jreus/imac-pcb/imac-pcb-front.png

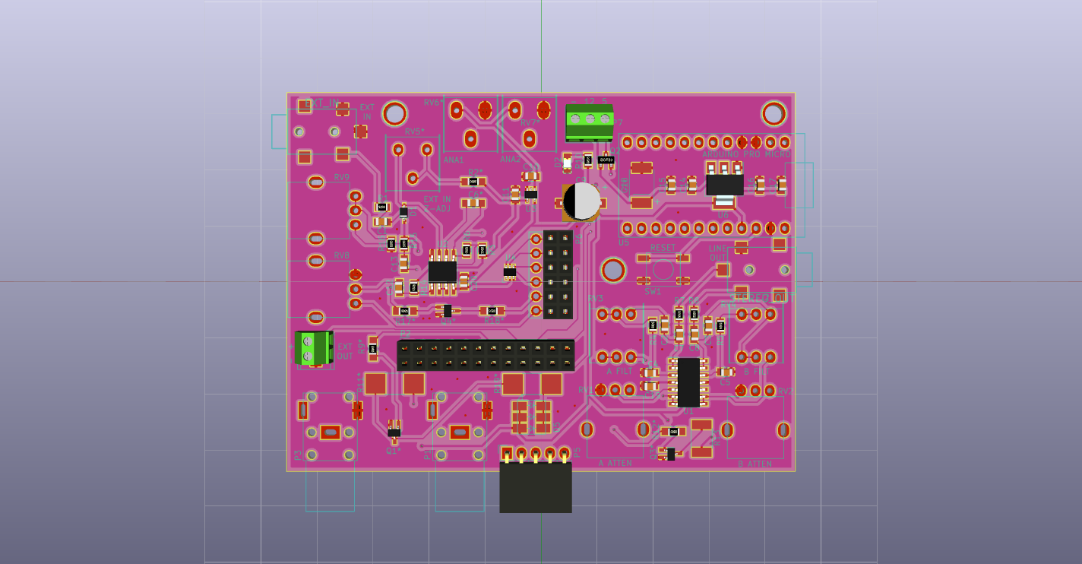
imac-pcb-front.png
