jreus/imac-pcb/imac-pcb-back.png

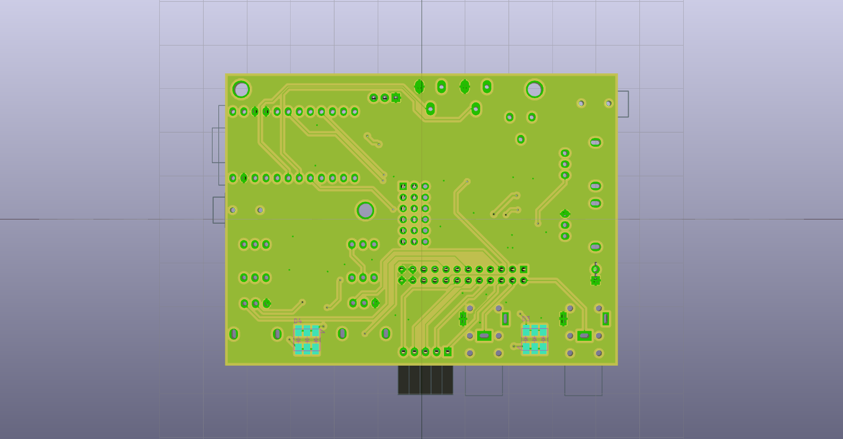
imac-pcb-back.png
