jreus/imac-pcb/Documentation/imac-pcb-3d-v01.png

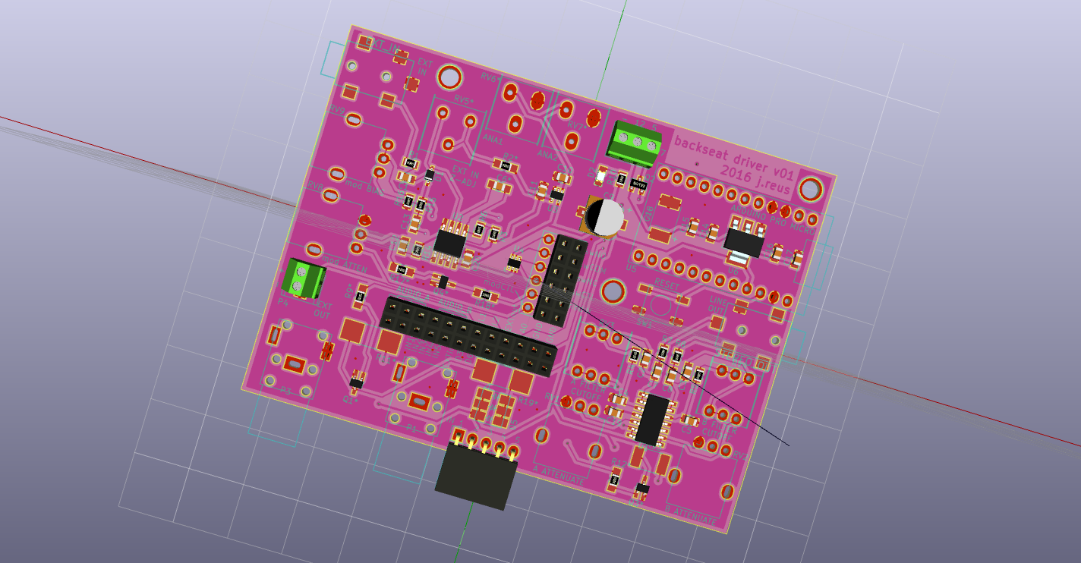
Documentation/imac-pcb-3d-v01.png
