jreus/imac-pcb/Documentation/Simulation/CREE-3SMD-transistor-drivers.png

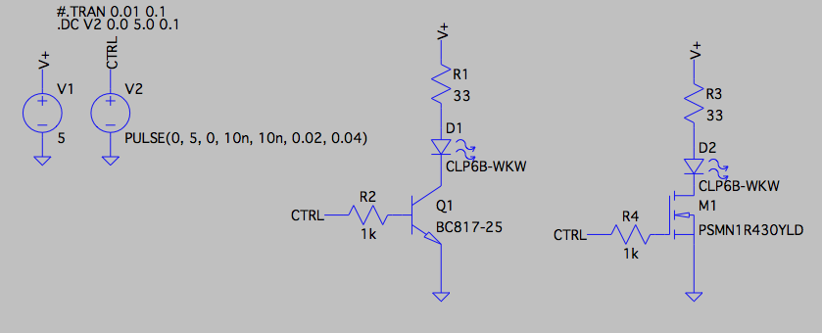
Documentation/Simulation/CREE-3SMD-transistor-drivers.png
