jreus/imac-pcb/Documentation/Simulation/mod_input_stage02.png

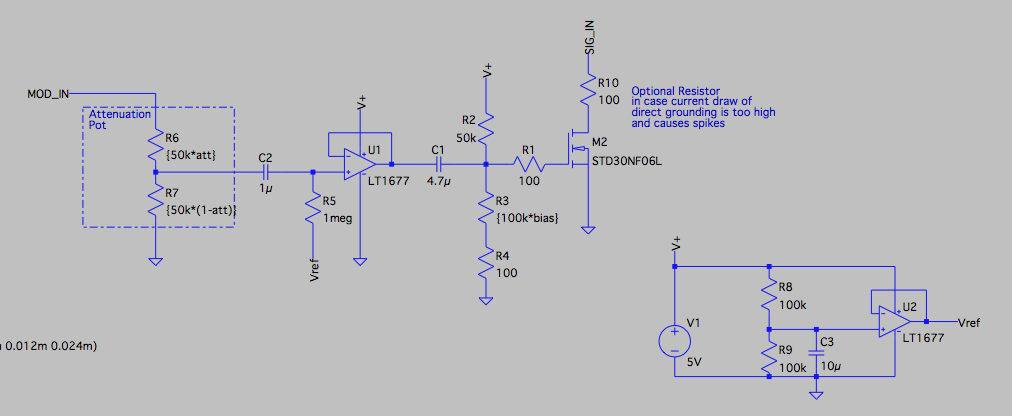
Documentation/Simulation/mod_input_stage02.png
