jreus/imac-pcb/Documentation/Simulation/mod_input_stage.png

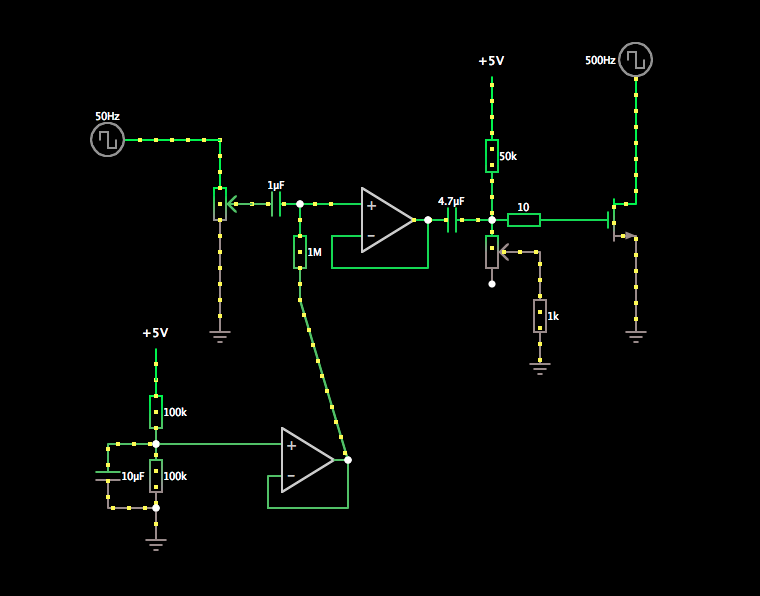
Documentation/Simulation/mod_input_stage.png
