jreus/imac-pcb/imac-pcb-BOM.ods

Sheet: BOM_RUN1
Notes | Link | Value | # per board | Footprint | Supplier | Supplier no | Cost/unit | Cost/N | N | MIN N | Cost/Board | In hand | Tot Needed (6 boards) | Still To order
PCB COMPONENTS
CONNECTORS
 | http://nl.farnell.com/lumberg/1503-03/connector-receptacle-3-5mm-phono/dp/1216980 | 3.5mm SMD headphone connector | 2 |  | Farnell | 1216980 | € 2.5200 | € 2.52 | 1 |  | € 5.0400 | 6 | 12 | 6
bigger wire gauge & lower price | http://nl.farnell.com/te-connectivity-buchanan/282834-3/terminal-block-wire-to-brd-3pos/dp/2396254 | 3x terminal block 16awg 282834-3 | 1 | 2.54mm x3 | Farnell | 2396254 | € 1.1500 | € 1.15 | 1 |  | € 1.1500 | 1 | 6 | 5
optional for breakout points | http://nl.farnell.com/te-connectivity-buchanan/282834-2/terminal-block-wire-to-brd-2pos/dp/2112482 | 2x terminal block 16awg 282834-2 | 1 | 2.54mm x2 | Farnell | 2112482 | € 1.0100 | € 1.01 | 1 |  | € 1.0100 | 1 | 6 | 5
 | http://nl.farnell.com/pro-signal/psg01546/socket-phono-pcb-gold-white/dp/1280701 | 2 pack RCA socket white | 1 |  | Farnell | 1280701 | € 1.1600 | 1.16 | 1 |  | € 1.1600 | 2 | 6 | 4
 | http://nl.farnell.com/samtec/ces-105-02-t-s-ra/socket-2-54mm-r-a-1x5way/dp/1803400 | 5x1 header fem angled | 1 | 2.54mm x5 | Farnell | 1803400 | € 0.5740 | € 14.35 | 25 | 25 | € 0.5740 | 10 | 6 | -4
 | http://nl.farnell.com/samtec/ssw-112-01-t-d/socket-2-54mm-2x12way/dp/1804590 | 12x2 fem header | 1 | 2.54mm x2x12 | Farnell | 1804590 | € 2.5000 | € 2.50 | 1 |  | € 2.5000 | 10 | 6 | -4
 | http://nl.farnell.com/samtec/ssw-106-01-t-t/socket-2-54mm-3x6way/dp/1804317 | 6x3 fem header | 1 | 2.54mm x3x6 | Farnell | 1804317 | € 1.5900 | € 15.90 | 10 | 10 | € 1.5900 | 10 | 6 | -4
 | http://nl.farnell.com/multicomp/2212s-12sg-85/socket-pcb-1-row-12way/dp/1593465 | 12x1 fem header | 2 | 2.54mm x2x12 | Farnell | 1593465 | € 0.1760 | € 3.52 | 20 | 5 | € 0.3520 | 0 | 12 | 12
POTS & TRIMMERS & SWITCHES |  |  |  |  |  |  | #DIV/0! |  |  |  | #DIV/0! | 0 | 0 | 0
 | http://nl.farnell.com/bourns/3386f-1-104tlf/trimmer-100k/dp/9354581 | 100k thru-hole trimpot with knob | 1 | 2.54mm x3 tri | Farnell | 9354581 | € 3.3800 | € 3.38 | 1 |  | € 3.3800 | 3 | 6 | 3
 | http://nl.farnell.com/vishay/m63m105kb30t607/trimmer-1m/dp/9608290 | 1meg thru-hole trimpot with knob | 1 | 2.54mm x3 tri | Farnell | 9608290 | € 1.9000 | € 19.00 | 10 | 10 | € 1.9000 | 3 | 6 | 3
 | http://nl.farnell.com/bourns/3310h-001-104l/potentiometer-100k/dp/9353933 | stereo 100k linpot bourns | 2 | 2.54mm x3 x2 rows | Farnell | 9353933 | € 7.4000 | € 7.4000 | 1 |  | € 14.8000 | 2 | 12 | 10
 | http://nl.farnell.com/bourns/ptv09a-4020f-b104/pot-rotary-100kohm-9mm-20/dp/2469525 | 100k 20% linpot bourns 9mm | 4 | 2.54mm x3 row | Farnell | 2469525 | € 0.9570 | 0.957 | 1 |  | € 3.8280 | 6 | 24 | 18
 |  | knob |  |  |  |  | #DIV/0! |  |  |  | #DIV/0! | 0 | 0 | 0
 |  | knob |  |  |  |  | #DIV/0! |  |  |  | #DIV/0! | 0 | 0 | 0
reset button | http://nl.farnell.com/c-k-components/ksem31g-lfs/tactile-switch-spst-0-05a-32vdc/dp/2435310 | SMD tactile switch | 1 |  | Farnell | 2435310 | € 0.2580 | 0.258 | 1 |  | € 0.2580 | 0 | 6 | 6
 |  |  |  |  |  |  |  |  |  |  |  |  | 0
DISCREET SEMICONDUCTORS |  |  |  |  |  |  |  |  |  |  |  |  | 0
For LED driver circuits or as an alternative MOSFET? | http://nl.farnell.com/nxp/nx3008nbkw/mosfet-n-ch-30v-350ma-sot323/dp/2069546 | NX3008N MOSFET | 3 | SOT323 / SC-70 | Farnell | 2069546 | € 0.0527 | € 1.32 | 25 | 25 | € 0.1581 | 0 | 18 | 18
Why did I buy this? For LED driver circuits? | http://nl.farnell.com/nxp/bc817-25-215/transistor-bjt-npn-45v-0-5a-sot/dp/1081224 | BC817 BJT NPN transistor | 3 | SOT323 / SC-70 | Farnell | 1081224 | € 0.0101 | € 0.01 | 1 |  | € 0.0303 | 0 | 18 | 18
polarity protection p-chan mosfet. Vgs 12v max | http://nl.farnell.com/nxp/pmv48xp/mosfet-p-ch-20v-3-5a-sot23/dp/1894743 | PMV48XP P-ch mosfet | 1 | SOT23 | Farnell | 1894743 | € 0.1930 | € 0.19 | 1 | 1 | € 0.1930 | 0 | 6 | 6
surge protect small sig diodes | http://nl.farnell.com/fairchild-semiconductor/1n4148ws/diode-small-signal-75v-sod-323f/dp/2453269 | 1N4148 | 1 | SOD-323F | Farnell | 2453269 | € 0.1390 | € 0.70 | 5 | 5 | € 0.1390 | 0 | 6 | 6
 |  |  |  |  |  |  |  |  |  |  |  |  | 0
ICs |  |  |  |  |  |  |  |  |  |  |  |  | 0
quad op-amp | http://nl.farnell.com/microchip/mcp6004-e-sl/ic-op-amp-quad-1mhz-smd-soic14/dp/1332122 | MCP6004 | 1 | SOIC14 | Farnell | 1332122 | € 0.4390 | € 4.39 | 10 | 10 | € 0.4390 | 4 | 6 | 2
dual op-amp | http://nl.farnell.com/microchip/mcp6002-e-sn/ic-op-amp-1mhz-0-6v-us-4500uv/dp/1332118 | MCP6002 | 1 | SOIC8 | Farnell | 1332118 | € 0.3360 | € 3.36 | 10 | 10 | € 0.3360 | 0 | 6 | 6
 | https://www.htfelectronics.nl/nl/arduino-pro-micro.html | Arduino Pro Micro | 1 | 2.54mm 2x12 | HTF Electronics |  | € 7.7500 | € 7.75 | 1 |  | € 7.7500 | 2 | 6 | 4
2.5 V ref | http://nl.farnell.com/on-semiconductor/ncp4620hsq25t1g/ldo-volt-reg-0-15a-2-5v-sc70-5/dp/2464263 | NCP4620 2.5V reg | 1 | SC70-5 | Farnell | 2464263 | € 0.3120 | € 0.31 | 1 |  | € 0.3120 | 0 | 6 | 6
 | http://nl.farnell.com/on-semiconductor/ncp1117st50t3g/ldo-reg-20vin-1a-5v-1-sot223-3/dp/2112617 | ncp1117 1A LDO 5V reg | 1 | SOT-223-3 | Farnell | 2112617 | € 0.0283 | € 0.28 | 10 | 10 | € 0.0283 | 0 | 6 | 6
1ch SPDT 0.5ohm analog switch | http://nl.farnell.com/analog-devices/adg849yksz-500rl7/ic-analog-switch-spdt-2-1-sc70/dp/1651265 | ADG849 | 1 | SC70-6 | Farnell | 1651265RL | € 1.4700 | € 14.70 | 10 | 10 | € 1.4700 | 10 | 6 | -4
 |  |  |  |  |  |  |  |  |  |  |  | 0 | 0
LEDS |  |  |  |  |  |  |  |  |  |  |  |  | 0
18cd | http://nl.farnell.com/cree/clp6b-wkw-cd0e0453/led-smd-plcc6-4mm/dp/1855533 | SMD 4mm white LED 50mA 3.8V | 3 | PLCC6 | Farnell | 1855533 | € 1.0900 | € 1.09 | 1 |  | € 3.2700 | 0 | 18 | 18
2mA low power LED | http://nl.farnell.com/kingbright/kp-2012lsgc/led-green-0-8mcd-568nm-smd/dp/2463991 | Green 2mA 1.9V | 1 | SMD 0805 | Farnell | 2463991 | € 0.0738 | € 0.37 | 5 | 5 | € 0.0738 | 0 | 6 | 6
 |  |  |  |  |  |  | #DIV/0! |  |  |  | #DIV/0! |  | 0 | 0
RESISTORS |  |  |  |  |  |  |  |  |  |  |  |  | 0
Cree LED Limiting | http://nl.farnell.com/panasonic-electronic-components/erju12f27r0u/res-thick-film-27r-1-0-75w-1812/dp/2380866 | 27 750mW | 3 | SMD 1812 | Farnell | 2380866 | € 0.2400 | € 2.40 | 10 | 10 | € 0.7200 | 0 | 18 | 18
ext_in input impedance | http://nl.farnell.com/walsin/wf08p3302ftl/res-thick-film-33k-1-0-25w-0805/dp/2670085 | 33k 250mW | 1 | SMD 0805 | Farnell | 2670085 | € 0.0359 | € 0.36 | 10 | 10 | € 0.0359 | 0 | 6 | 6
ext_in feedback gain | http://nl.farnell.com/walsin/wf08p1001ftl/resistor-thick-film-1k-1-150v/dp/2502785 | 1k 250mW | 1 | SMD 0805 | Farnell | 2332003 | € 0.0225 | € 0.23 | 10 | 10 | € 0.0225 | 0 | 6 | 6
ext_in filter impedance | http://nl.farnell.com/te-connectivity/crgh0805f220r/res-thick-film-220r-1-0-33w-0805/dp/2332063 | 220 330mW | 2 | SMD 0805 | Farnell | 2332063 | € 0.0359 | € 0.36 | 10 | 10 | € 0.0718 | 0 | 12 | 12
ext_in feedback gain | http://nl.farnell.com/te-connectivity/crgh0805f3k3/res-thick-film-3k3-1-0-33w-0805/dp/2332078 | 3.3k 330mW | 2 | SMD 0805 | Farnell | 2332078 | € 0.0359 | € 0.36 | 10 | 10 | € 0.0718 | 0 | 12 | 12
 | http://nl.farnell.com/te-connectivity/crgh0805f100r/res-thick-film-100r-1-0-33w-0805/dp/2332058 | 100 330mW | 7 | SMD 0805 | Farnell | 2332058 | € 0.0133 | € 1.33 | 100 | 100 | € 0.0931 | 0 | 42 | 42
for power indicator led | http://nl.farnell.com/te-connectivity/crgh0805f1k5/res-thick-film-1k5-1-0-33w-0805/dp/2332074 | 1.5k 330mW | 1 | SMD 0805 | Farnell | 2332074 | € 0.0200 | € 0.20 | 10 | 10 | € 0.0200 | 0 | 6 | 6
mod 2.5 ref input bias | http://nl.farnell.com/walsin/wf08p1004ftl/resistor-thick-film-1m-1-150v/dp/2502788 | 1meg 250mW | 1 | SMD 0805 | Farnell | 2502788 | € 0.0225 | € 0.23 | 10 | 10 | € 0.0225 | 0 | 6 | 6
 |  |  |  |  |  |  | #DIV/0! |  |  |  | #DIV/0! |  | 0 | 0
 |  |  |  |  |  |  | #DIV/0! |  |  |  | #DIV/0! |  | 0 | 0
 |  |  |  |  |  |  | #DIV/0! |  |  |  | #DIV/0! |  | 0 | 0
CAPACITORS |  |  |  |  |  |  |  |  |  |  |  |  | 0
 | http://nl.farnell.com/multicomp/mc0805x105k250ct/cap-mlcc-x5r-1uf-25v-0805/dp/2320832 | 1u 25V 10% | 9 | SMD 0805 | Farnell | 2320832 | € 0.0338 | € 0.34 | 10 | 10 | € 0.3042 | 0 | 54 | 54
filter | http://nl.farnell.com/multicomp/mc0805b683k500ct/cap-mlcc-x7r-68nf-50v-0805/dp/1759262 | 68n 50V 10% | 2 | SMD 0805 | Farnell | 1759262 | € 0.0189 | € 0.19 | 10 | 10 | € 0.0378 | 0 | 12 | 12
filter | http://nl.farnell.com/multicomp/mcu0805r103kct/cap-mlcc-x7r-10nf-50v-0805/dp/9406352 | 10n 50V 10% | 2 | SMD 0805 | Farnell | 9406352 | € 0.0146 | € 0.15 | 10 | 10 | € 0.0292 | 0 | 12 | 12
pwr | http://nl.farnell.com/panasonic-electronic-components/eeefte221xap/cap-alu-elec-220uf-25v-smd/dp/1868409 | 220u 25V 20% elco | 1 | elco 6.3x7.7 | Farnell | 1868409 | € 0.5070 | € 0.51 | 1 | 1 | € 0.5070 | 10 | 6 | -4
pwr decoupling | http://nl.farnell.com/multicomp/mc0805b104k500ct/cap-mlcc-x7r-100nf-50v-0805/dp/1759265 | 100n 50V 10% | 4 | SMD 0805 | Farnell | 1759265 | € 0.0156 | € 0.16 | 10 | 10 | € 0.0624 | 0 | 24 | 24
pwr decoupling | http://nl.farnell.com/avx/tajd226k020rnj/cap-tant-22uf-20v-case-d/dp/498804 | 22u tantalum 20V 10% | 1 | SMD 2917 / 7343 | Farnell | 498804 | € 0.5050 | € 7.58 | 15 | 15 | € 0.5050 | 20 | 6 | -14
ext in gain stability | http://nl.farnell.com/multicomp/mc0805b221k500ct/cap-mlcc-x7r-220pf-50v-0805/dp/1759208 | 220p 50V 10% | 1 | SMD 0805 | Farnell | 1759208 | € 0.0198 | € 0.20 | 10 | 10 | € 0.0198 | 0 | 6 | 6
 |  |  |  |  |  |  | #DIV/0! |  |  |  | #DIV/0! |  | 0 | 0
ACCESSORIES |  |  |  |  |  |  | #DIV/0! |  |  |  | #DIV/0! |  | 0 | 0
 | http://www.reichelt.nl/A-V-Cables-Jacks-/GC-M0064/3/index.html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 | 3.5mm stereo->2xRCA high quality cable |  | angled head | Reichelt | GC M0064 | € 3.1000 | € 3.10 | 1 |  | € 0.0000 | 1 | 0 | -1
 | http://www.reichelt.nl/A-V-Cables-Jacks-/GC-M0058/3/index.html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 | 3.5mm stereo->2xRCA high quality cable |  | straight head | Reichelt | GC M0058 | € 3.0000 | € 3.00 | 1 |  | € 0.0000 | 1 | 0 | -1
 | http://www.reichelt.nl/A-V-Cables-Jacks-/AVK-213/3/index.html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 | 3.5mm stereo->2xRCA cable |  | daisy chainable | Reichelt | AVK 213 | € 1.0200 | € 1.02 | 1 |  | € 0.0000 | 2 | 0 | -2
 | http://www.reichelt.nl/A-V-Adapters-RCA-Jacks-DIN-/NTA-175/3/index.html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 | RCA→JACK adapter |  |  | Reichelt | NTA 175 | € 0.2500 | € 0.25 | 1 |  | € 0.0000 | 6 | 0 | -6

Sheet: RESEARCH
Notes | Link | Value | Amount | Footprint | Supplier | Supplier no | Cost/unit | Cost/N | N | MIN N | Cost/Board | In hand | Tot Needed (3 boards) | Still To order
PCB COMPONENTS
CONNECTORS
 | http://nl.farnell.com/lumberg/1503-03/connector-receptacle-3-5mm-phono/dp/1216980 | 3.5mm SMD headphone connector | 4 |  | Farnell | 1216980 | € 2.5200 | € 2.52 | 1 |  | € 10.0800 | 6 | 12 | 6
smaller & cheaper version? | http://nl.farnell.com/lumberg/1503-13-vp3/socket-3-5mm-jack-smt-4way/dp/1368640 | 3.5 SMD headphone connector
bigger wire gauge & lower price | http://nl.farnell.com/te-connectivity-buchanan/282834-3/terminal-block-wire-to-brd-3pos/dp/2396254 | 3x terminal 16awg 282834-3 | 1 | 2.54mm x3 | Farnell | 2396254 | € 1.1500 | € 1.15 | 1 |  | € 1.1500 | 1 | 3 | 2
 | http://nl.farnell.com/phoenix-contact/1725669/terminal-block-wire-to-brd-3pos/dp/3041360 | 3 way screwterminal 20awg | 0 | 2.54mm x3 | Farnell | 3041360 | € 2.1300 | € 2.13 | 1 |  | € 0.0000 | 1 | 0 | -1
optional for breakout points | http://nl.farnell.com/te-connectivity-buchanan/282834-2/terminal-block-wire-to-brd-2pos/dp/2112482 | 2x terminal 16awg 282834-2 | 0 | 2.54mm x2 | Farnell | 2112482 | € 1.0100 | € 1.01 | 1 |  | € 0.0000 | 2 | 0 | -2
not necessary can plug in banana to patchbays | http://nl.farnell.com/cliff-electronic-components/fcr7350l/socket-pcb-4mm-r-a-s16n-pc-blue/dp/1854511 | PCB banana plug socket | 0 |  | Farnell | 1854511 | € 2.6500 | € 2.65 | 1 |  | € 0.0000 | 1 | 0 | -1
 | http://nl.farnell.com/pro-signal/psg01546/socket-phono-pcb-gold-white/dp/1280701 | 2 pack RCA socket white | 1 | ??? | Farnell | 1280701 | € 1.1600 | 1.16 | 1 |  | € 1.1600 | 2 | 3 | 1
kind of large board connection... also scope probes have very high input Z | http://nl.farnell.com/te-connectivity-amp/5-1634503-1/rf-coaxial-bnc-straight-jack-50ohm/dp/1020980 | BNC jack 50ohm PCB | 0 | ??? | Farnell | 1020980 | € 1.5400 | € 1.54 | 1 |  | € 0.0000 | 1 | 0 | -1
for connecting SMD clips (right-angle version?) | http://nl.farnell.com/samtec/ssw-105-01-g-s/connector-rcpt-5pos-1row-2-54mm/dp/2578707 | 5x header fem straight | 1 | 2.54mm x5 | Farnell | 2578707 | € 1.7800 | € 1.78 | 1 |  | € 1.7800 | 1 | 3 | 2
cheaper? | http://nl.farnell.com/samtec/slw-105-01-t-s/socket-2-54mm-1x5way/dp/1803344
smaller quantities possible | http://nl.farnell.com/harwin/m20-7820546/socket-pcb-0-1-5way/dp/7991940
 | http://nl.farnell.com/samtec/ces-105-02-t-s-ra/socket-2-54mm-r-a-1x5way/dp/1803400 | 5x1 header fem angled? | 1 | 2.54mm x5 | Farnell |  | € 0.5740 | € 14.35 | 25 | 25 | € 0.5740 | 0 | 3 | 3
smaller quantities possible? | http://nl.farnell.com/samtec/smh-105-02-t-s/receptacle-2-54mm-tht-r-a-5way/dp/2019782 | is it thru hole?
 | http://nl.farnell.com/samtec/ssw-112-01-t-d/socket-2-54mm-2x12way/dp/1804590 | 12x2 fem header | 1 | 2.54mm x2x12 | Farnell | 1804590 | € 2.5000 | € 2.50 | 1 |  | € 2.5000 | 5 | 3 | -2
DISCREET SEMICONDUCTORS
 | http://nl.farnell.com/stmicroelectronics/std30nf06lt4/mosfet-n-ch-60v-35a-dpak/dp/1752032 | STD30NF06LT4 POWER MOSFET | 2 | TO-252 | Farnell | 1752032 | € 0.6940 | € 0.69 | 1 |  | € 1.3880 | 10 | 6 | -4
For LED driver circuits or as an alternative MOSFET? | http://nl.farnell.com/nxp/nx3008nbkw/mosfet-n-ch-30v-350ma-sot323/dp/2069546 | NX3008N MOSFET | 2 | SOT323 / SC-70 | Farnell | 2069546 | € 1.6940 | € 1.69 | 1 |  | € 3.3880 | 10 | 6 | -4
Why did I buy this? For LED driver circuits? | http://nl.farnell.com/nxp/bc817-25-215/transistor-bjt-npn-45v-0-5a-sot/dp/1081224 | BC817 BJT NPN transistor | 0 | SOT323 / SC-70 | Farnell | 1081224 | € 0.0101 | € 0.01 | 1 |  | € 0.0000 | 10 | 0 | -10
polarity protection p-chan mosfet. Vgs 12v max | http://nl.farnell.com/nxp/pmv48xp/mosfet-p-ch-20v-3-5a-sot23/dp/1894743 | PMV48XP P-ch mosfet | 1 | SOT23 | Farnell | 1894743 | € 0.1930 | € 0.19 | 1 | 1 | € 0.1930 | 0 | 3 | 3
surge protect small sig diodes | http://nl.farnell.com/fairchild-semiconductor/1n4148ws/diode-small-signal-75v-sod-323f/dp/2453269 | 1N4148 | 1 | SOD-323F | Farnell | 2453269 | € 0.1390 | € 0.70 | 5 | 5 | € 0.1390 | 0 | 3 | 3
ICs
GP op-amp | http://nl.farnell.com/microchip/mcp6004-e-sl/ic-op-amp-quad-1mhz-smd-soic14/dp/1332122 | MCP6004 | 1 | SOIC14 | Farnell | 1332122 | € 0.4390 | € 4.39 | 10 | 10 | € 0.4390 | 0 | 3 | 3
GP op-amp | http://nl.farnell.com/microchip/mcp6002-e-sn/ic-op-amp-1mhz-0-6v-us-4500uv/dp/1332118 | MCP6002 | 1 | SOIC8
 | http://nl.farnell.com/arduino-org/a000093/board-arduino-micro-headerless/dp/2285196?ost=2285196 | Arduino Micro | 1 |  | Farnell | 2285196 | € 23.6600 | € 23.66 | 1 |  | € 23.6600 | 1 | 3 | 2
2.5 V ref | http://nl.farnell.com/on-semiconductor/ncp4620hsq25t1g/ldo-volt-reg-0-15a-2-5v-sc70-5/dp/2464263 | NCP4620 | 1 | SC70-5 | Farnell | 2464263 | € 0.3120 | € 0.31 | 1 |  | € 0.3120 | 3 | 3 | 0
vreg | http://nl.farnell.com/texas-instruments/ua78m05idcy/v-reg-5v-0-5a-78m05-sot-223-4/dp/1494947 | 5V 0.5A reg | 1 | SOT-223-3 | Farnell | 1494947 | € 0.4980 | € 0.50 | 1 |  |  | 0 | 3 | 3
cheaper w higher current, but bigger output caps | http://nl.farnell.com/on-semiconductor/ncp1117st50t3g/ldo-reg-20vin-1a-5v-1-sot223-3/dp/2112617 | 1A LDO 5V |  | SOT-223-3 | Farnell | 2112617 | € 0.0283 | € 0.28 | 10 | 10
not available... until week 11? :-/ | http://nl.farnell.com/vishay/dg2525dn-t1-ge4/analogue-switch-4-ch-spdt-miniqfn/dp/2675732 | DG2525DN-T1-GE4 quad SPDT switch | 1 | Mini QFN 16 | Farnell | 2675732 | € 0.9410 | € 0.94 | 1 |  | € 0.9410 | 0 | 3 | 3
1ch SPDT 0.5ohm analog switch | http://nl.farnell.com/analog-devices/adg849yksz-500rl7/ic-analog-switch-spdt-2-1-sc70/dp/1651265 | ADG849 | 1 | SC70-6 | Farnell | 1651265RL | € 1.4700 | € 14.70 | 10 | 10 | € 1.4700 | 10 | 3 | -7
 |  |  |  |  |  |  |  |  |  |  |  | 0
POTS & TRIMMERS & SWITCHES |  |  |  |  |  |  | #DIV/0! |  |  |  | #DIV/0! | 0 | 0 | 0
 | http://nl.farnell.com/bourns/3386f-1-104tlf/trimmer-100k/dp/9354581 | 100k thru-hole trimpot with knob | ??? | ??? | Farnell | 9354581 | € 3.3800 | € 3.38 | 1 |  | #VALUE! | 3 | #VALUE! | #VALUE!
significantly cheaper, but harder to adjust | http://www.reichelt.nl/Trimmers-Pots-Miniature/23A-100K/3/index.html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 | 100k SMD trimpot flathead |  |  | Reichelt | 23A-100K | € 0.6000 | € 0.60 | 1 |  | € 0.0000 | 5 | 0 | -5
 | http://nl.farnell.com/vishay/m63m105kb30t607/trimmer-1m/dp/9608290 | 1meg thru-hole trimpot with knob |  |  | Farnell | 9608290 | € 1.9000 | € 19.00 | 10 | 10 | € 0.0000 | 0 | 0 | 0
 | http://nl.farnell.com/bourns/3310h-001-104l/potentiometer-100k/dp/9353933 | stereo 100k linpot bourns | 2 | 2.54mm x3 x2 rows | Farnell | 9353933 | € 7.4000 | € 7.4000 | 1 |  | € 14.8000 | 3 | 6 | 3
 | http://nl.farnell.com/bourns/ptv09a-4020f-b104/pot-rotary-100kohm-9mm-20/dp/2469525 | 100k 20% linpot bourns 9mm | ??? |  | Farnell | 2469525 | € 0.9570 | 0.957 | 1 |  | #VALUE! | 6 | #VALUE! | #VALUE!
 | http://nl.farnell.com/alps/rk09k1130c94/pot-rotary-100k-17mm-20/dp/1191742 | 100k 20% linpot alps 17mm | ??? |  | Farnell | 1191742 | € 1.1900 | 1.19 | 1 |  | #VALUE! | 6 | #VALUE! | #VALUE!
reset button | http://nl.farnell.com/c-k-components/ksem31g-lfs/tactile-switch-spst-0-05a-32vdc/dp/2435310 | tactile switch |  |  | Farnell | 2435310
LEDS | those cree leds I like are 4.18cd
3.17cd | http://nl.farnell.com/cree/cla1b-wkw-xe0f0e13/led-cool-white-8300k-3-177cd-plcc/dp/2430032 | SMD white LED 30mA 3.2V | ??? | PLCC4 | Farnell | 2430032 | € 0.2460 | € 0.25 | 1 |  | #VALUE! | 2 | #VALUE! | #VALUE!
18cd | http://nl.farnell.com/cree/clp6b-wkw-cd0e0453/led-smd-plcc6-4mm/dp/1855533 | SMD 4mm white LED 50mA 3.8V | ??? | PLCC6 | Farnell | 1855533 | € 1.0900 | € 1.09 | 1 |  | #VALUE! | 1 | #VALUE! | #VALUE!
nice case, but thru-hole, 5.2cd | http://nl.farnell.com/cree/cp41b-wes-ck0p0154/led-cool-white-5-2cd/dp/1855518 | thru-hole white LED 30mA
2mA low power LED | http://nl.farnell.com/kingbright/kp-2012lsgc/led-green-0-8mcd-568nm-smd/dp/2463991 | Green 2mA 1.9V | 1 | SMD 0805 | Farnell | 2463991 | € 0.0738 | € 0.37 | 5 | 5 | € 0.0738 | 0 | 3 | 3
 |  |  |  |  |  |  | #DIV/0! |  |  |  | #DIV/0! |  | 0 | 0
 | http://nl.farnell.com/texas-instruments/tca6507pw/led-driver-7ch-i2c-smb-tssop14/dp/1647813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 | i2c LED driver |  |  |  |  | #DIV/0! |  |  |  | #DIV/0! |  | 0 | 0
RESISTORS
Cree LED Limiting | http://nl.farnell.com/panasonic-electronic-components/erju12f27r0u/res-thick-film-27r-1-0-75w-1812/dp/2380866 | 27 750mW | 2 | SMD 1812 | Farnell | 2380866 | € 0.2400 | € 2.40 | 10 | 10 | € 0.4800 | 0 | 6 | 6
ext_in input impedance | http://nl.farnell.com/te-connectivity/crgh0603f33k/res-thick-film-33k-1-0-2w-0603/dp/2332022 | 33k 200mW | 1 | SMD 0603 | Farnell | 2332022 | € 0.0359 | € 0.36 | 10 | 10 | € 0.0359 | 0 | 3 | 3
ext_in feedback gain | http://nl.farnell.com/te-connectivity/crgh0603f1k0/res-thick-film-1k-1-0-2w-0603/dp/2332003 | 1k 200mW | 1 | SMD 0603 | Farnell | 2332003 | € 0.0225 | € 0.23 | 10 | 10 | € 0.0225 | 0 | 3 | 3
ext_in filter impedance | http://nl.farnell.com/te-connectivity/crgh0603f220r/res-thick-film-220r-1-0-2w-0603/dp/2331993 | 220 200mW | 2 | SMD 0603 | Farnell | 2331993 | € 0.0359 | € 0.36 | 10 | 10 | € 0.0718 | 0 | 6 | 6
ext_in feedback gain | http://nl.farnell.com/te-connectivity/crgh0603f3k3/res-thick-film-3k3-1-0-2w-0603/dp/2332009 | 3.3k 200mW | 2 | SMD 0603 | Farnell | 2332009 | € 0.0359 | € 0.36 | 10 | 10 | € 0.0718 | 0 | 6 | 6
 | http://nl.farnell.com/te-connectivity/crgh0603f100r/res-thick-film-100r-1-0-2w-0603/dp/2331989 | 100 200mW |  | SMD 0603 | Farnell | 2331989 | € 0.0133 | € 1.33 | 100 | 100 | € 0.0000 | 0 | 0 | 0
for power indicator led | http://nl.farnell.com/te-connectivity/crgh0603f1k5/res-thick-film-1k5-1-0-2w-0603/dp/2332005 | 1.5k 200mW | 1 | SMD 0603 | Farnell | 2332005 | € 0.0200 | € 0.20 | 10 | 10 | € 0.0200 | 0 | 3 | 3
mod 2.5 ref input bias | http://nl.farnell.com/te-connectivity/crgh0603f1m0/res-thick-film-1m-1-0-2w-0603/dp/2332042 | 1meg 200mW | 1 | SMD 0603 | Farnell | 2332042 | € 0.0225 | € 0.23 | 10 | 10 | € 0.0225 | 0 | 3 | 3
 |  |  |  |  |  |  | #DIV/0! |  |  |  | #DIV/0! |  | 0 | 0
 |  |  |  |  |  |  | #DIV/0! |  |  |  | #DIV/0! |  | 0 | 0
 |  |  |  |  |  |  | #DIV/0! |  |  |  | #DIV/0! |  | 0 | 0
CAPACITORS
 | http://nl.farnell.com/multicomp/mc0805x105k250ct/cap-mlcc-x5r-1uf-25v-0805/dp/2320832 | 1u 25V 10% |  | SMD 0805 | Farnell | 2320832 | € 0.0338 | € 0.34 | 10 | 10 | € 0.0000 | 0 | 0 | 0
filter | http://nl.farnell.com/multicomp/mc0805b683k500ct/cap-mlcc-x7r-68nf-50v-0805/dp/1759262 | 68n 50V 10% | 2 | SMD 0805 | Farnell | 1759262 | € 0.0189 | € 0.19 | 10 | 10 | € 0.0378 | 0 | 6 | 6
filter | http://nl.farnell.com/multicomp/mcu0805r103kct/cap-mlcc-x7r-10nf-50v-0805/dp/9406352 | 10n 50V 10% | 2 | SMD 0805 | Farnell | 9406352 | € 0.0146 | € 0.15 | 10 | 10 | € 0.0292 | 0 | 6 | 6
pwr | http://nl.farnell.com/panasonic-electronic-components/eeefte221xap/cap-alu-elec-220uf-25v-smd/dp/1868409 | 220u 25V 20% elco | 1 | elco 6.3x7.7 | Farnell | 1868409 | € 0.5070 | € 0.51 | 1 | 1 | € 0.5070 | 0 | 3 | 3
 |  |  |  |  |  |  | #DIV/0! |  |  |  | #DIV/0! |  | 0 | 0
 |  |  |  |  |  |  | #DIV/0! |  |  |  | #DIV/0! |  | 0 | 0
 |  |  |  |  |  |  | #DIV/0! |  |  |  | #DIV/0! |  | 0 | 0
 |  |  |  |  |  |  | #DIV/0! |  |  |  | #DIV/0! |  | 0 | 0
ACCESSORIES |  |  |  |  |  |  | #DIV/0! |  |  |  | #DIV/0! |  | 0 | 0
 | http://www.reichelt.nl/A-V-Cables-Jacks-/GC-M0064/3/index.html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 | 3.5mm stereo->2xRCA high quality cable |  | angled head | Reichelt | GC M0064 | € 3.1000 | € 3.10 | 1 |  | € 0.0000 | 1 | 0 | -1
 | http://www.reichelt.nl/A-V-Cables-Jacks-/GC-M0058/3/index.html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 | 3.5mm stereo->2xRCA high quality cable |  | straight head | Reichelt | GC M0058 | € 3.0000 | € 3.00 | 1 |  | € 0.0000 | 1 | 0 | -1
 | http://www.reichelt.nl/A-V-Cables-Jacks-/AVK-213/3/index.html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 | 3.5mm stereo->2xRCA cable |  | daisy chainable | Reichelt | AVK 213 | € 1.0200 | € 1.02 | 1 |  | € 0.0000 | 2 | 0 | -2
 | http://www.reichelt.nl/A-V-Adapters-RCA-Jacks-DIN-/NTA-175/3/index.html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 | RCA→JACK adapter |  |  | Reichelt | NTA 175 | € 0.2500 | € 0.25 | 1 |  | € 0.0000 | 6 | 0 | -6

Sheet: References
Reference | Value | Library | Library Ref
R1 | 100 | device | R
C20 | 100nF | device | C
C5 | 100nF | device | C
R12 | 10k | device | R
R2 | 120k | device | R
C12 | 1uF | device | CP1
C13 | 1uF | device | CP1
C18 | 1uF | device | CP1
C19 | 1uF | device | CP1
C6 | 1uF | device | CP1
C7 | 1uF | device | CP1
C1 | 220pF | device | C
C14 | 220pF | device | C
C15 | 220pF | device | C
C2 | 220pF | device | C
C8 | 220pF | device | C
C9 | 220pF | device | C
R10 | 28.7k | device | R
R11 | 28.7k | device | R
R13 | 28.7k | device | R
R14 | 28.7k | device | R
R15 | 28.7k | device | R
R16 | 28.7k | device | R
R4 | 28.7k | device | R
R5 | 28.7k | device | R
R6 | 28.7k | device | R
R7 | 28.7k | device | R
R8 | 28.7k | device | R
R9 | 28.7k | device | R
C10 | 440pF | device | C
C11 | 440pF | device | C
C16 | 440pF | device | C
C17 | 440pF | device | C
C3 | 440pF | device | C
C4 | 440pF | device | C
R3 | 68k | device | R
P3 | BATTERY | conn | CONN_01X02
U3 | BEAGLEBONEBLACK | beagleboneblack | BEAGLEBONEBLACK
P1 | BELA_AINS | wearable_cape | BELA_AINS
P4 | BELA_AOUTS | wearable_cape | BELA_AOUTS
P5 | CONN_01X04 | conn | CONN_01X04
P6 | CONN_01X04 | conn | CONN_01X04
P7 | CONN_01X04 | conn | CONN_01X04
U1 | MCP6004 | linear | MCP6004
U2 | MCP6004 | linear | MCP6004
U4 | OKI_7805 | oki_7805 | OKI_7805
P2 | RECEIVER | conn | CONN_02X04
SW1 | SW_HALT | device | SW_PUSH
SW2 | SW_MODE_SEL | device | SW_PUSH
C21 | CP1 | device | CP1
C22 | CP1 | device | CP1
P5 | PWR_OUT | conn | CONN_01X02
J1 | JACK_3P | jack_3p | JACK_3P
J2 | JACK_3P | jack_3p | JACK_3P
J3 | JACK_3P | jack_3p | JACK_3P
C23 | C | device | C
C24 | C | device | C
R23 | 100k | device | R
R25 | 100k | device | R
R24 | 100k | device | R
R34 | 100k | device | R
R32 | 100k | device | R
R33 | 100k | device | R
R19 | 150k | device | R
R20 | 200k | device | R
R17 | 150k | device | R
R18 | 200k | device | R
R21 | 150k | device | R
R22 | 200k | device | R
R30 | 150k | device | R
R31 | 200k | device | R
R28 | 150k | device | R
R29 | 200k | device | R
R26 | 150k | device | R
R27 | 200k | device | R
