jreus/imac-pcb/Documentation/imac-pcb-print.pdf

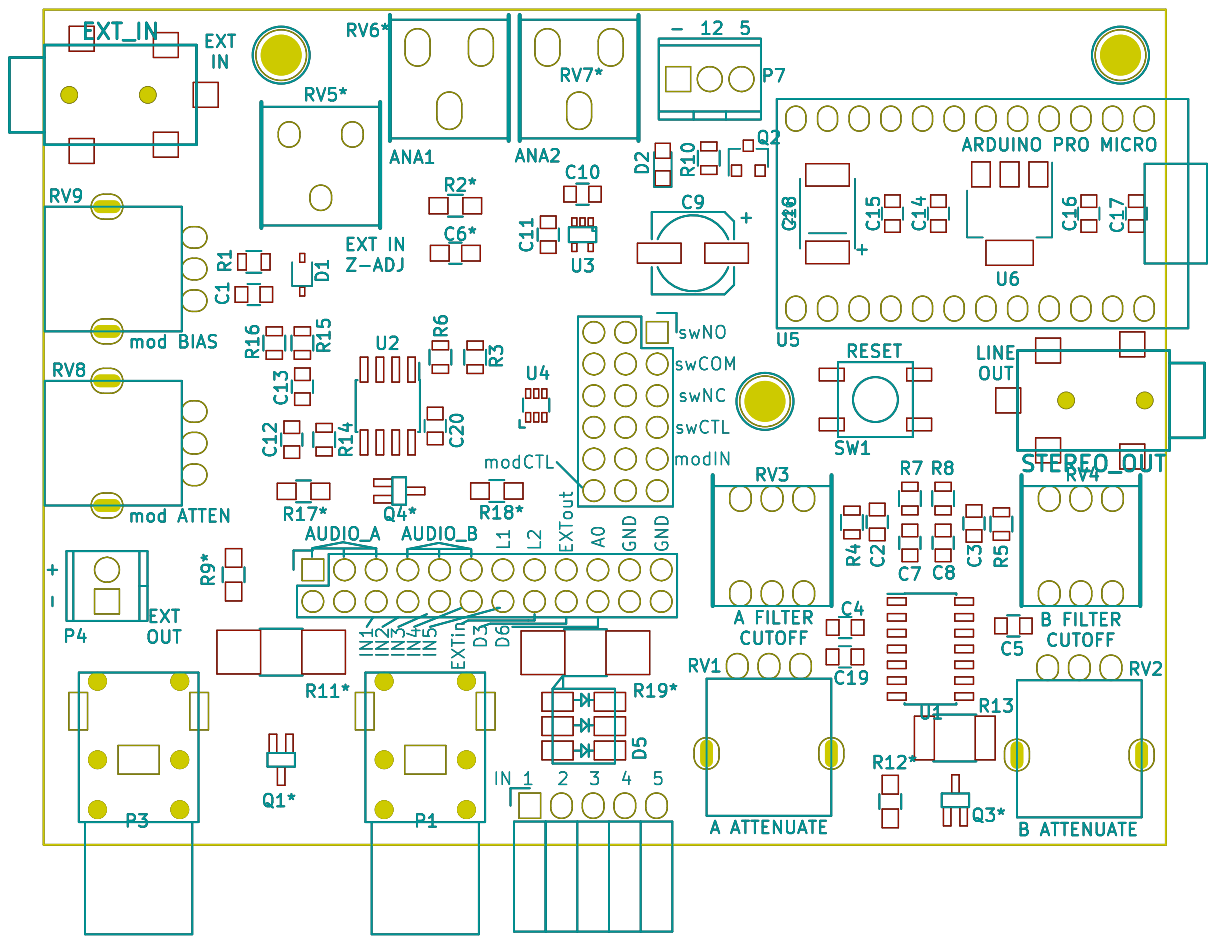
[picture p7: page 1]
