jreus/imac-pcb/Documentation/imac-pcb-schematic.pdf

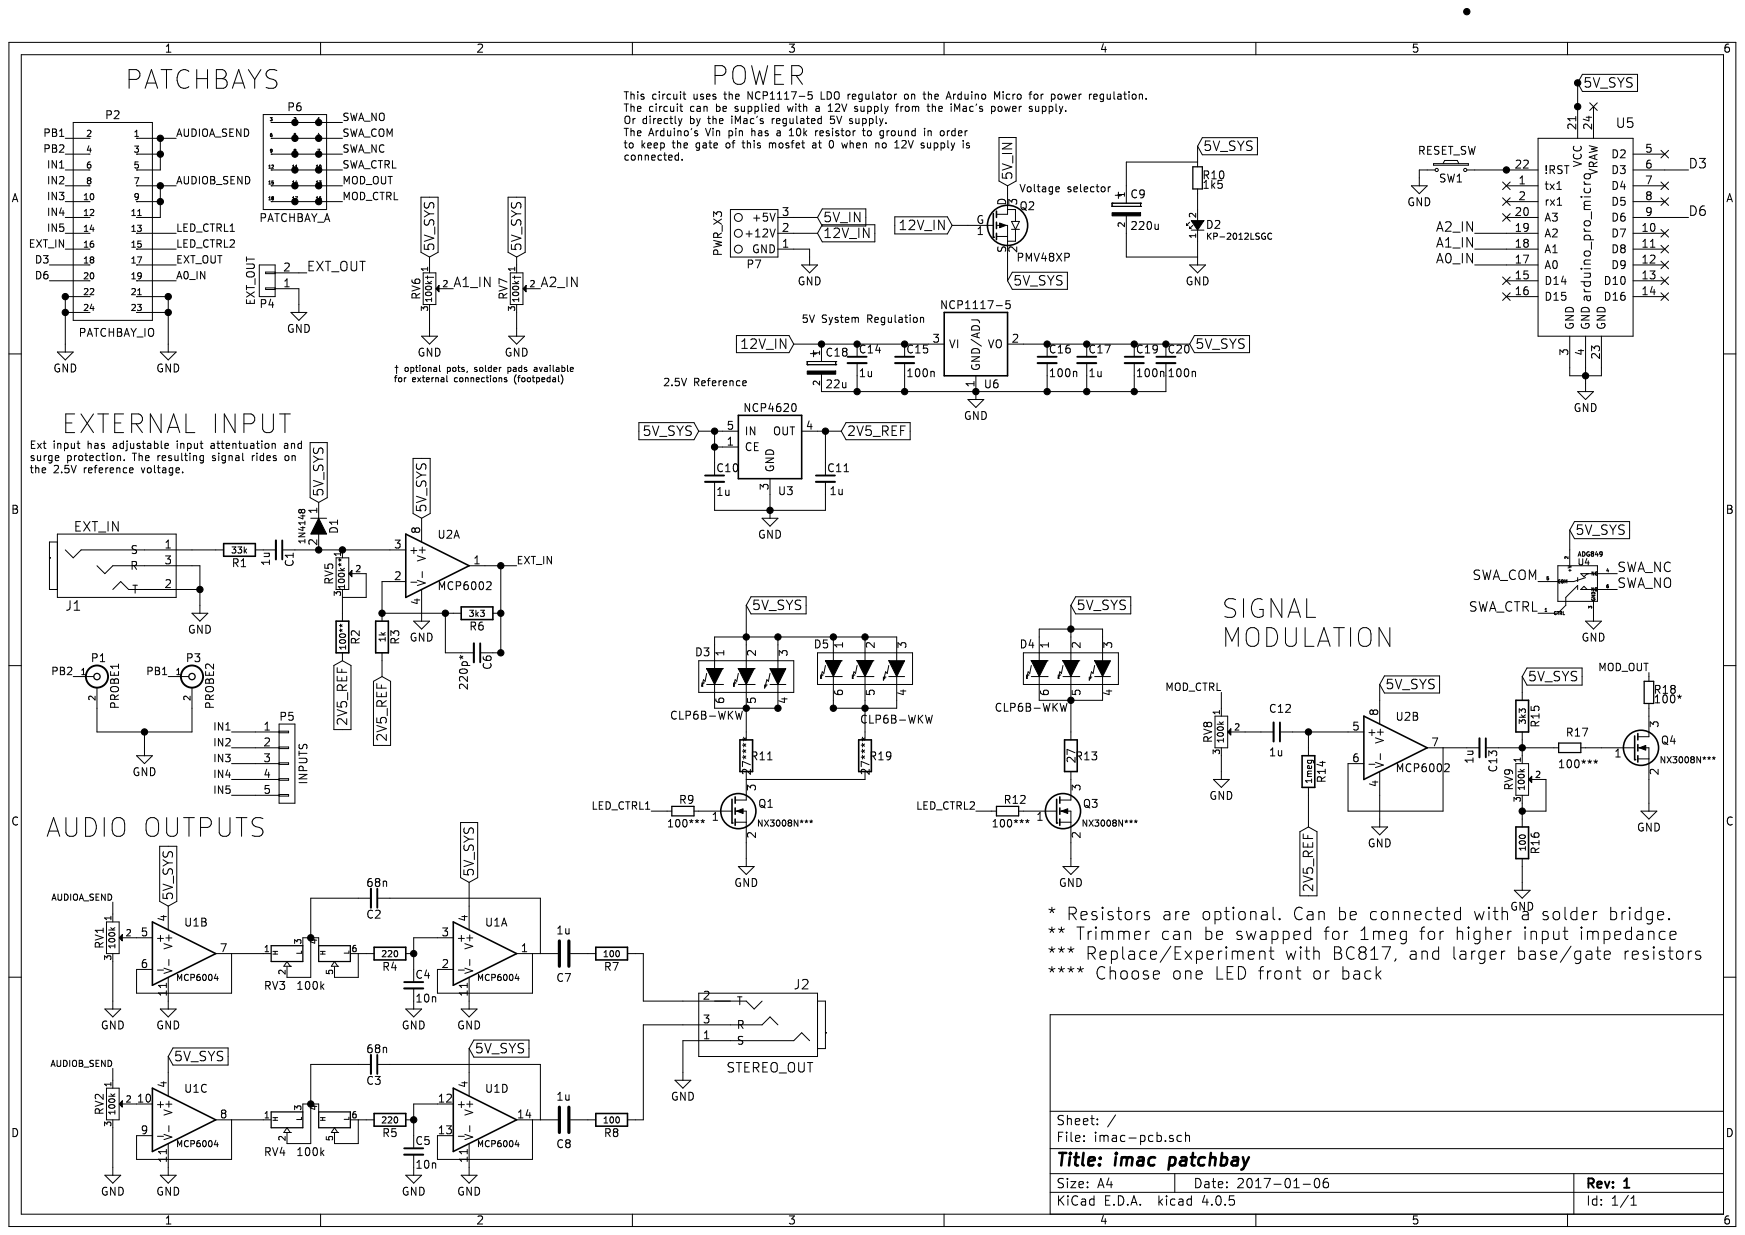
[picture p8: page 1]
