jreus/imac-pcb/Documentation/print-schematic.pdf

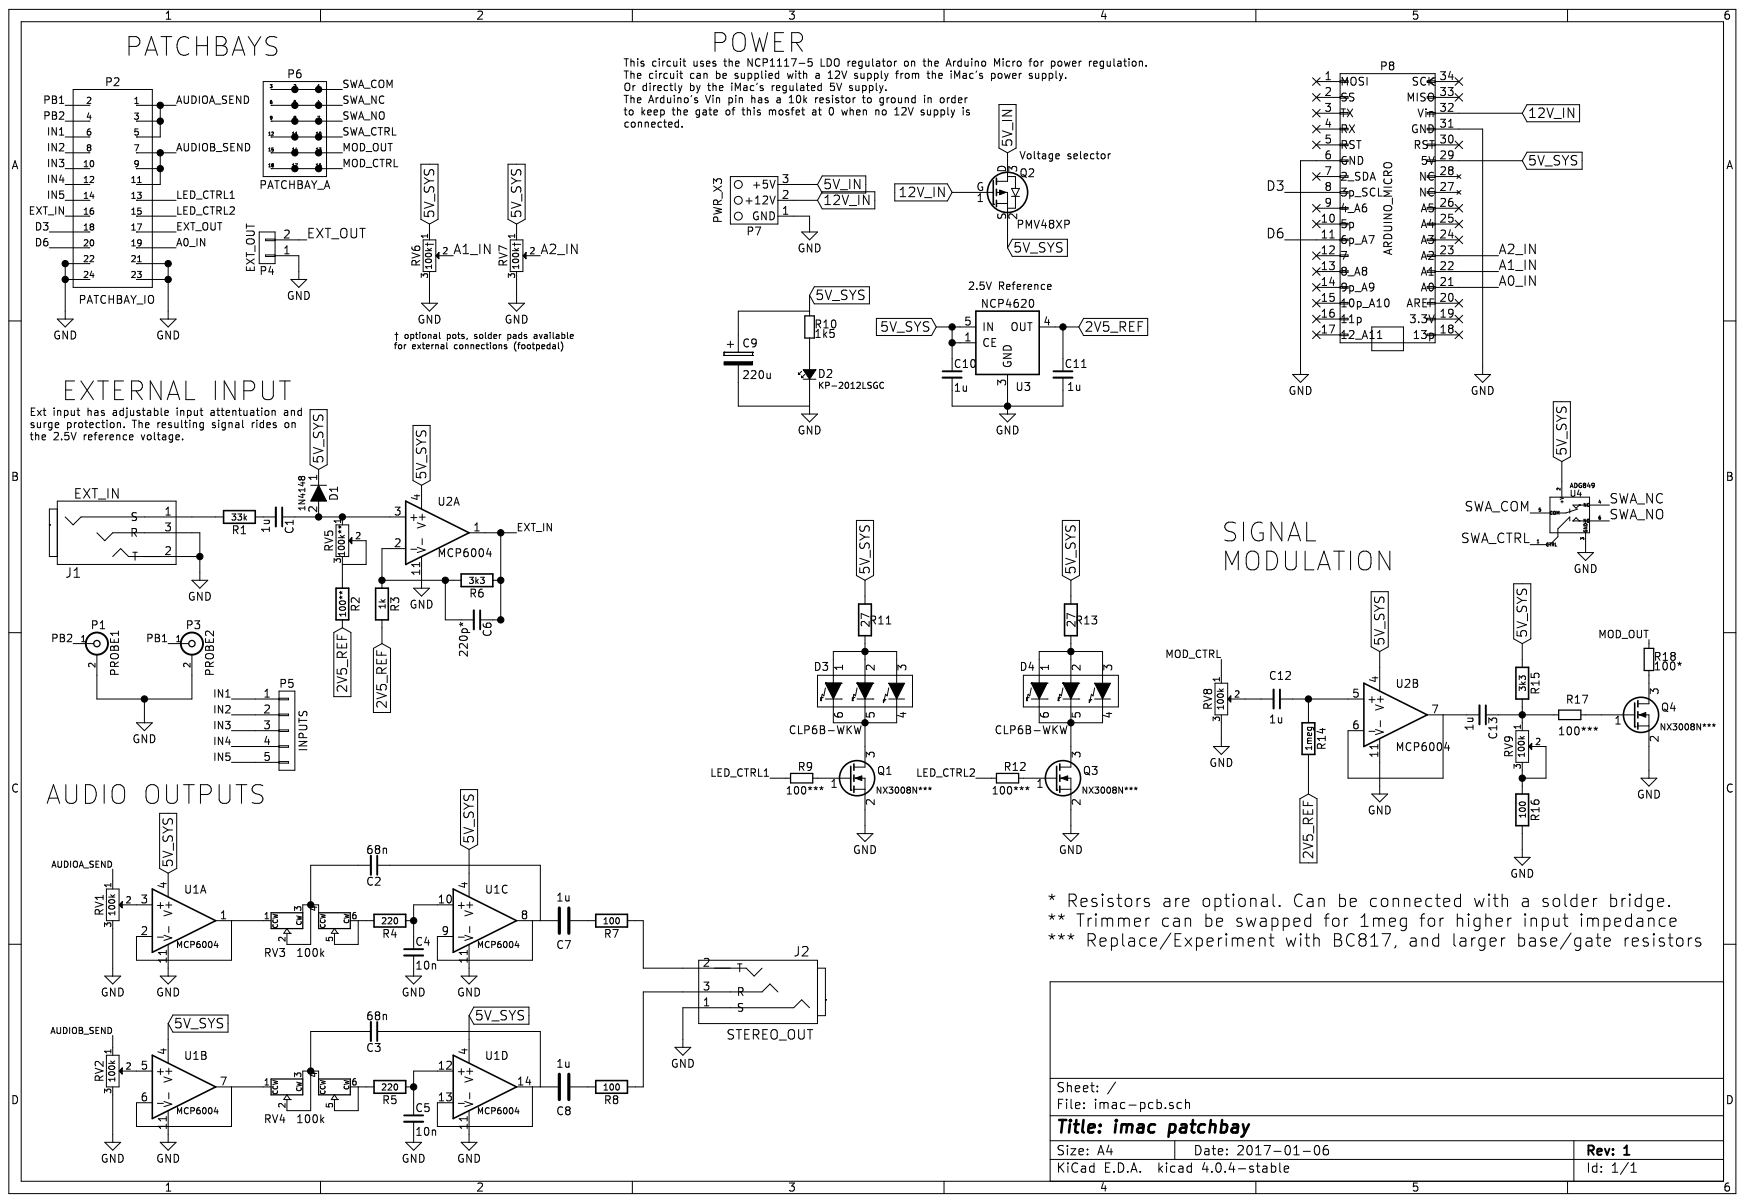
[picture p9: page 1]
