jreus/imac-pcb/Documentation/Simulation/led_driver.asc

D1: LED; CLP6B-WKW
D2: LED; CLP6B-WKW
M1: nmos; PSMN1R430YLD
Q1: npn; BC817-25
R1: res; 27
R2: res; 10k
R3: res; 27
R4: res; 1k
V1: voltage; 5
V2: voltage; PULSE(0, 5, 0, 10n, 10n, 0.02, 0.04)
Named nets: V+, 0, CTRL
#.TRAN 0.01 0.1
.DC V2 0.0 5.0 0.1
.model LUMILED D(Is=4.5e-20 Rs=.85 N=2.6 Cjo=1.18n Xti=200 Iave=400mA Vpk=5 mfg=Lumiled type=LED)
.model CLP6B-WKW D(Is=8.3613e-10 Rs=8.5869 N=7.03159 Cjo=1.18n Xti=200 BV=15 mfg=Cree type=LED)
