jreus/imac-pcb/Documentation/Simulation/mod_input_stage.asc

C1: cap; 1µ
C2: cap; 1µ
M2: nmos; STD30NF06L
M3: nmos; PSMN1R430YLD
Q1: npn; BC817-25
Q2: npn; BC817-25
R1: res; 100
R2: res; 50k
R3: res; {100k*bias}
R4: res; 100
R5: res; 1meg
R6: res; {100k*att}
R7: res; {100k*(1-att)}
R8: res; 50k
R9: res; 50k
R10: res; 100
R11: res; {100k*bias}
R12: res; 100
R13: res; 100
U1: LT1677
V1: voltage; 5V
V2: voltage; SINE(0 1.2 2000); AC 1.2; Rser=600
V3: voltage; PULSE(0 3.3 0 15n 15n 0.00001 0.00002); Rser=50
V4: voltage; 2.5V
V5: voltage; PULSE(0 5.0 0 30n 30n 0.001 0.002); AC 5 0; Rser=10
V6: voltage; SINE(0 2.0 2000); AC 0.5; Rser=600
Named nets: 0, FROM_EXT, V+, Vref, SIG_TO_MOD, FROM_DUINO, Vbias, Vatten
.INCLUDE models/std30nf06.txt
.PARAM att=0.001
.PARAM bias=0.2
.TRAN 0.1 0.001
#.AC DEC 100 5 300
#V3=3.3V
#.DC V6 -2.5 2.5 0.01
Attenuation
Pot
Optional Resistor
in case current draw of 
direct grounding is too high
and causes spikes
INPUT STAGE CIRCUIT
FOR MODULATION SIGNALS
ALL MODULATION SIGNALS ARE ASSUMED TO BE POSITIVE
TRANSISTOR RESPONSE TEST
