jreus/imac-pcb/Documentation/Simulation/adjustable_filter.asc

C1: cap; {C1}
C2: cap; {C2}
R1: res; {pot}
R2: res; {pot}
R3: res; 1meg
U1: LT1677
V1: voltage; 5
V2: voltage; 2.5
V3: voltage; PULSE(0.85 4.15 0 10n 10n 0.00001 0.00002); AC 3.3; Rser=1
V4: voltage; PULSE(0.85 4.15 0 10n 10n 0.00007 0.0001); AC 3.3; Rser=1
Named nets: 0, V+, Vref, 10k_PULSE, NEXT_STAGE, 50k_PULSE, N002
AUDIO FILTER STAGE
SIG_IN should be riding on a Vref bias voltage 
and be entirely positive.
.PARAM C1=100n
.PARAM C2=22n
.STEP PARAM pot list 100k 75k 50k 40k 30k 20k 10k 5k 2k 1k 700 500 300 200 100 10
.AC DEC 100 20 30000
#.IC V(N002)=2.5
#.TRAN 0.001 0.0009 0.0006
INPUT SHOULD BE BUFFERED
POT CAN SERVE AS A WEIRD
VOLUME CONTROL DUE TO
ITS EXTREME FILTERING
BUT WOULD BE NICE TO HAVE PRE-ATTENUATION
10 ohm PUTS THE BUMP OUTSIDE THE AUDIBLE RANGE
100k IS AN EXTREMELY LOW CUTOFF FREQUENCY
