jreus/imac-pcb/Documentation/Simulation/audio_output_stage.asc

C1: cap; {C1}; Rser=210.9m Lser=0 mfg="   ---" pn="   ---" type="   ---"
C2: cap; {C2}; Rser=143.6m Lser=0 mfg="   ---" pn="   ---" type="   ---"
C3: cap; 1µ; Rser=17.1m Lser=0 mfg="   ---" pn="   ---" type="   ---"
C4: cap; 1p
R1: res; 100k-{Rat}
R2: res; {Rat}
R3: res; {Rcf}
R4: res; {Rcf}
R5: res; 220
R6: res; 100
R7: res; 10k
U1: LT1006
U2: LT1006
V1: voltage; PULSE(0 3.3 0 10n 10n 1.5e-05 2e-05); Rser=50
V2: voltage; 2.5V
V3: voltage; 2.5V
V4: voltage; SINE(0 1.7 1000 0 0 0); AC 1.7; Rser=50
Named nets: SIG_CHIP, 0, VREF, AC_SWEEP
Attenuation
Pot
.param Rat=99.9k
#.PARAM Rcf=10k
.PARAM C1=10n
.PARAM C2=68n
.step param Rcf list 1 500 1k 10k 25k 50k 75k 100k
.tran 0.01 0.0003
#.ac DEC 100 1 30000
#.OP
AUDIO FILTER STAGE
SIG_IN should be riding on a Vref bias voltage
BUFFER-BIAS-VOLUME STAGE
SIG_IN should be biased and attenuated (if necessary)
LINE INPUT
