jreus/imac-pcb/Documentation/Simulation/audio_panning_stage.asc

R1: res; 3.57k
R2: res; 3.57k
R3: res; {10k*pan}
R4: res; {10k*(1-pan)}
U1: LT1677
U2: LT1677
V1: voltage; PULSE(0 3.3 0 10n 10n 0.001 0.002); AC 3.3; Rser=1
V2: voltage; 5V
Named nets: SIG_CHIP, 0, V+, OUT_L, OUT_R
.PARAM pan=0.5
.TRAN 0.001 1.005 1.0
