jreus/imac-pcb/Documentation/Simulation/ext_input_stage.asc

C1: cap; 1µ
C2: cap; 1µ
C3: cap; 220p
C4: cap; 20n
C5: cap; 20n
D1: diode; 1N4148
R1: res; {Rin}
R2: res; {Rz}
R3: res; 1meg
R4: res; 25k
R5: res; 1k
R6: res; 3.3k
R7: res; 25k
R8: res; 33k
U1: LT1677
V1: voltage; SINE(0 2 500 0 500 0 0); AC 2; Rser=1000
V2: voltage; 5
V3: voltage; 2.5
V4: voltage; SINE(0 0.2 500 0 0 0 0); AC 0.2; Rser=300
V5: voltage; SINE(0 1.0 3000 0 0 0 0); AC 1.2; Rser=600
V6: voltage; SINE(0 50 3000 0 500 0 0); AC 50; Rser=1000
Named nets: Vref, 0, V+, LINE, PIEZO_KNOCK, COIL, MOD_INPUT, PIEZO_BEND
PIEZO PRE-AMP
<- Adjustable INPUT Z
#.PARAM Rin=100k
.PARAM Rz=100
.STEP PARAM Rin list 1 1k 10k 25k 50k 75k 100k
#.TRAN 0.01 0.01
.AC DEC 100 1 500000
<- Make this resistor easily replacible..
have some backup values eg. 1meg
A piezo disk has around 15nF series capacitance  (depending on size)
A lightly attached piezo will generate around 2V p2p from a strong knock. But will easily generate 50V or more if given a strong bend.
LINE IN 1.2 V p2p with 600 ohm Z
33k resistor limits 
current spikes
within the threshhold of 
the op-amp (MCP6004)
Pickup coils are about 300ohms, light signals are around 
200mV p2p. Transformer coils generate around 2v p2p close up.
This is a very tricky circuit. Trying to negotiate a balance between
the high-Z piezo and lower impedance inputs.
The high-Z piezo has a large capacitance in its output
and so creates nasty hi-pass filters.
this cap just stabilizes the op-amp and filters out
>200khz frequencies, probably not totally necessary.
diode protects against
piezo high voltages
there is an internal diode up
from GND inside the MCP6004
