jreus/imac-pcb/Documentation/Simulation/audio_input_stage.asc

C2: cap; 0.1µ
R5: res; 1meg
R6: res; {100k*att}
R7: res; {100k*(1-att)}
U1: LT1677
V1: voltage; 5V
V2: voltage; 2.5V
V3: voltage; SINE(0 1.4 4000); AC 4.0; Rser=50
V4: voltage; PULSE(0 3.3V 0 10n 10n 0.00001 0.00003); AC 4.0; Rser=50
Named nets: SIG_IN, Vref, V+, 0, PULSE_IN, FILTER
.PARAM att=0.5
.TRAN 0.001 0.002 0.001
Attenuation
Pot
AUDIO INPUT STAGE
Takes signal mash from a mixture of VRAM pins
Buffers it and adds pre-filter attenuation.
