jreus/imac-pcb/Documentation/Simulation/piezo_input_stage.asc

C1: cap; 10µ
C2: cap; 1µ
C3: cap; 150p
R1: res; {Rin}
R2: res; 100
R4: res; 1meg
R5: res; 1k
R6: res; 2.2k
U1: LT1677
V1: voltage; SINE(0 20 3000 0 0 0 0); AC 10; Rser=5meg
V2: voltage; 5
V3: voltage; 2.5
V4: voltage; SINE(0 4 3000 0 0 0 0); AC 10; Rser=600
Named nets: Vref, 0, V+, COIL, PIEZO
PIEZO PRE-AMP
(ADJUSTABLE 10k-1meg?) INPUT Z
NEEDED DUE TO HIGH OUT-Z
OF CERAMIC PIEZO ELEMENTS
.PARAM Rin=100k
.TRAN 0.01 1.001 1.00
