jreus/imac-pcb/imac-pcb.kicad_pcb

## KiCad design imac-pcb.kicad_pcb (2017-01-29)

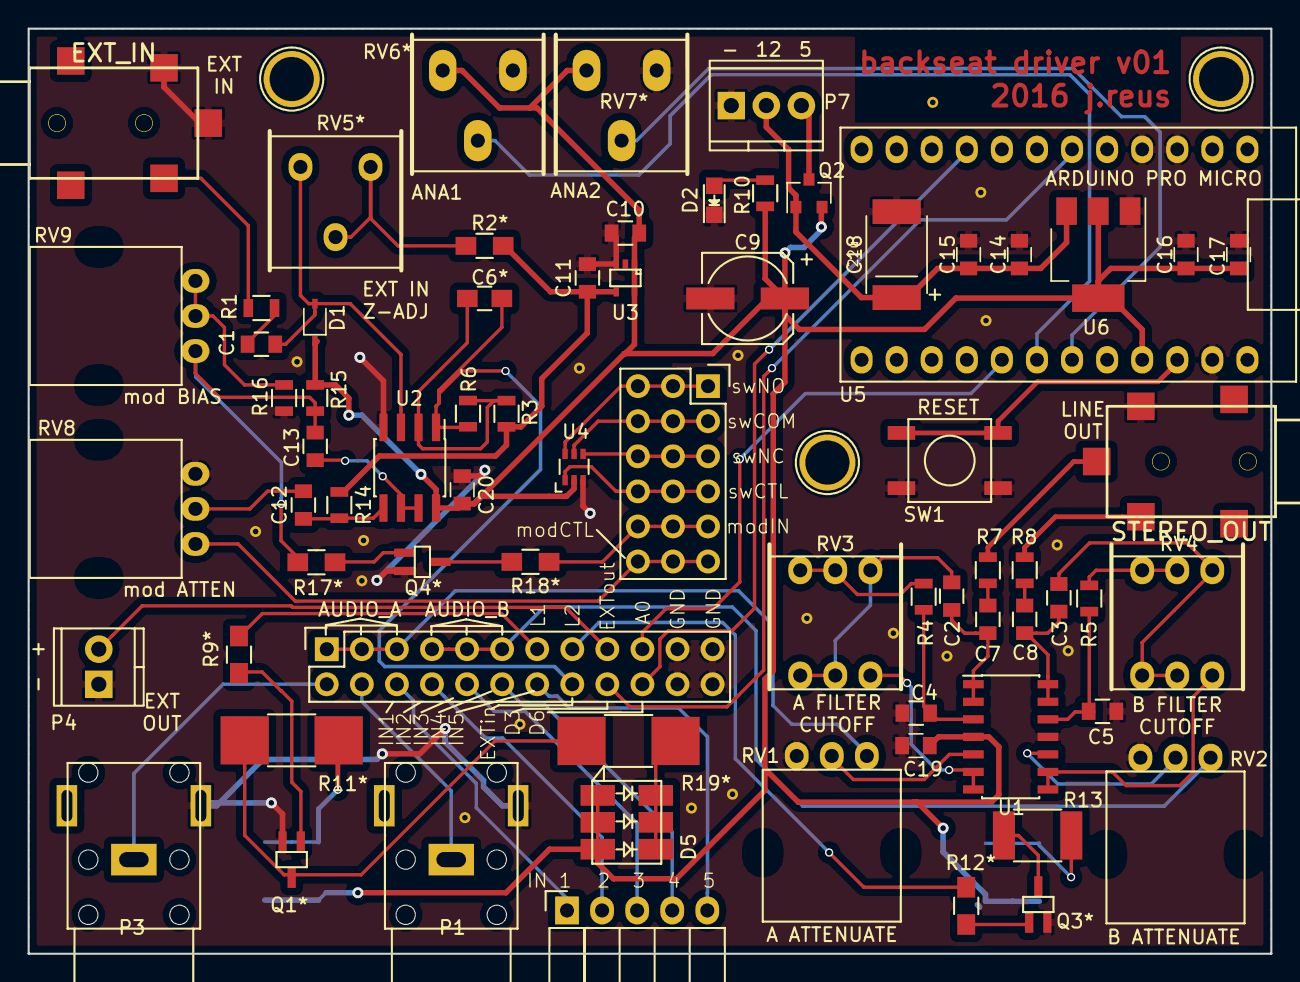
[picture p10: board imac-pcb.kicad_pcb from above]

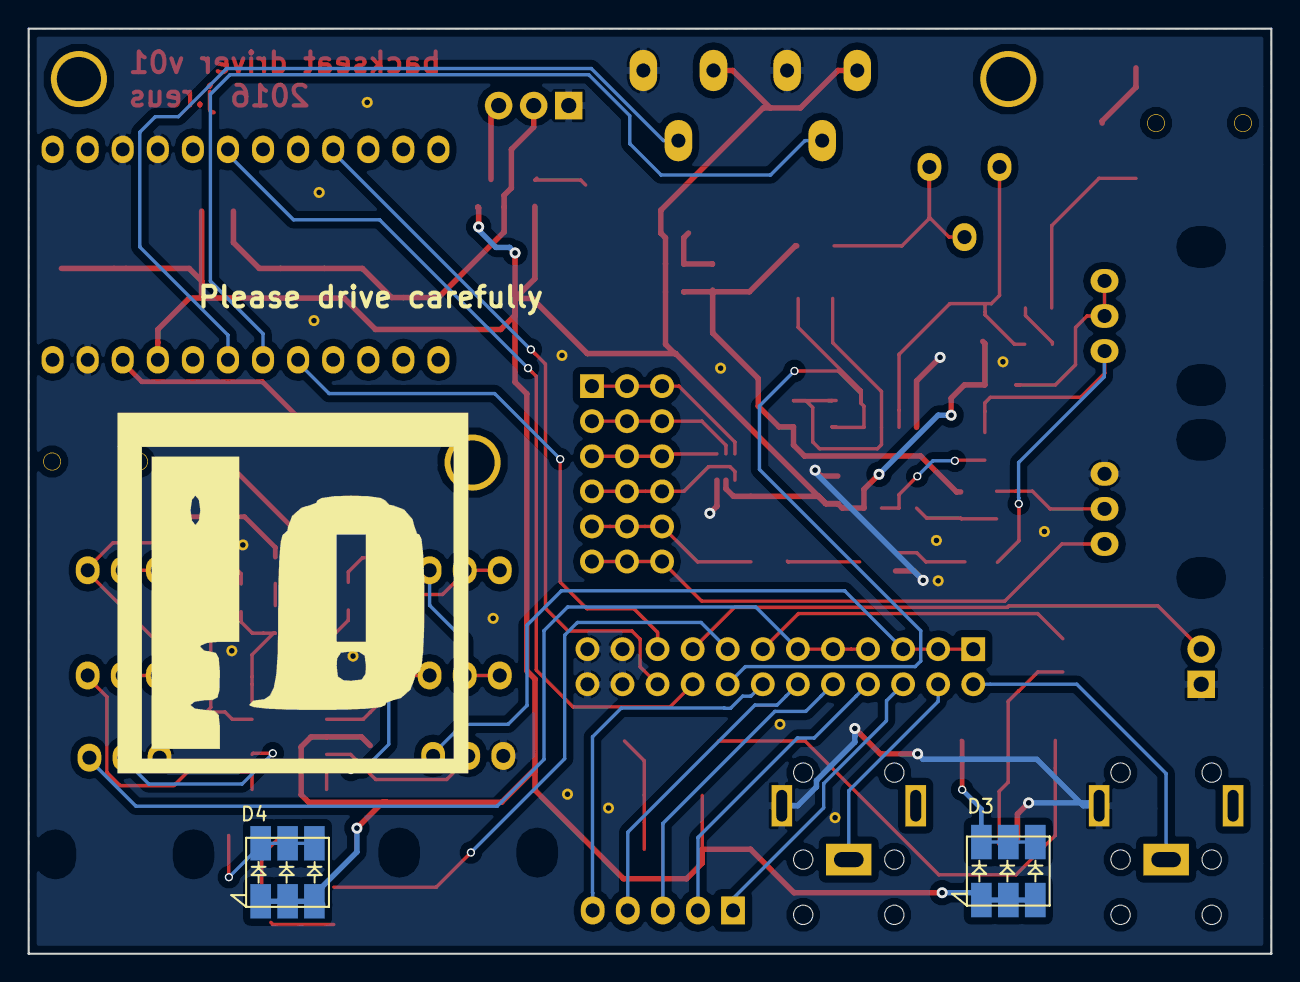
[picture p11: board imac-pcb.kicad_pcb from below]

Board: 2 copper layers, 90.0 x 67.0 mm, 73 parts (2 on the bottom side), 66 nets.

Parts:
C1, C7, C8, C10, C11, C12, C13, C14, C17: 1u; C_0805
C2, C3: 68n; C_0805
C4, C5: 10n; C_0805
C6*: 220p*; C_0805_HandSoldering
C9: 220u; c_elec_6.3x7.7
C15, C16, C19, C20: 100n; C_0805
C18: 22u; 2917C
D1: 1N4148; SOD-323F
D2: KP-2012LSGC; LED_0805
D3, D4, D5: CLP6B-WKW; PLCC6-3in1-SMD-LED
J1: EXT_IN; Lumberg_1503_03
J2: STEREO_OUT; Lumberg_1503_03
P1: PROBE1; PSG01546_RCA_Phono_Connector
P2: PATCHBAY_IO; Socket_Strip_Straight_2x12
P3: PROBE2; PSG01546_RCA_Phono_Connector
P4: EXT_OUT; TerminalBlock_TE_282834-2-2.54mm_2pol
P5: INPUTS; Socket_Strip_Angled_1x05
P6: PATCHBAY_A; Socket_Strip_Straight_3x06
P7: PWR_X3; TerminalBlock_TE_282834-3-2.54mm_3pol
Q1*, Q3*, Q4*: NX3008N***; SC-70-BIG-PADS
Q2: PMV48XP; SOT-23
R1: 33k; R_0805
R2*: 100**; R_0805_HandSoldering
R3: 1k; R_0805
R4, R5: 220; R_0805
R6, R15: 3k3; R_0805
R7, R8, R16: 100; R_0805
R9*, R12*, R17*: 100***; R_0805_HandSoldering
R10: 1k5; R_0805
R11*, R19*: 27****; R_1812_HandSoldering
R13: 27; R_1812
R14: 1meg; R_0805
R18*: 100*; R_0805_HandSoldering
RV1, RV2, RV8, RV9: 100k; Pot_Bourns_PTV09A-4_Horizontal_Rear_mount
RV3, RV4: 100k; Dual_Pot_Bourns_3301H-00X
RV5*: 100k**; Trimpot_Bourns_3386F_Vishay_M63
RV6*, RV7*: 100k†; Trimpot_Bourns_Big_Pads_3386F_Vishay_M63
SW1: RESET_SW; EVQ_BUT
U1: MCP6004; SOIC-14_3.9x8.7mm_Pitch1.27mm
U2: MCP6002; SOIC-8_3.9x4.9mm_Pitch1.27mm_handsolder
U3: NCP4620; SC-70-5
U4: ADG849; SC-70-6
U5: arduino_pro_micro
U6: NCP1117-5; SOT-223

Connections:
2V5_REF: C11.1, R2*.2, R3.2, R14.2, U3.4
5V_IN: P7.3, Q2.3
5V_SYS: C9.1, C10.1, C16.1, C17.1, C19.1, C20.1, D1.1, D3.1, D3.2, D3.3, D4.1, D4.2, D4.3, D5.1, D5.2, D5.3, Q2.2, R10.1, R15.1, RV6*.1, RV7*.1, U1.4, U2.8, U3.1, U3.5, U4.2, U5.21, U6.2, U6.4
12V_IN: C14.1, C15.1, C18.1, P7.2, Q2.1, U6.3
/A0_IN: P2.19, U5.17
/A1_IN: RV6*.2, U5.18
/A2_IN: RV7*.2, U5.19
/AUDIOA_SEND: P2.1, P2.3, P2.5, RV1.1
/AUDIOB_SEND: P2.7, P2.9, P2.11, RV2.1
/D3: P2.18, U5.6
/D6: P2.20, U5.9
/EXT_IN: C6*.1, P2.16, R6.1, U2.1
/EXT_OUT: P2.17, P4.2
/IN1: P2.6, P5.1
/IN2: P2.8, P5.2
/IN3: P2.10, P5.3
/IN4: P2.12, P5.4
/IN5: P2.14, P5.5
/LED_CTRL1: P2.13, R9*.2
/LED_CTRL2: P2.15, R12*.2
/MOD_CTRL: P6.16, P6.17, P6.18, RV8.1
/MOD_OUT: P6.13, P6.14, P6.15, R18*.1
/PB1: P2.2, P3.1
/PB2: P1.1, P2.4
/SWA_COM: P6.4, P6.5, P6.6, U4.5
/SWA_CTRL: P6.10, P6.11, P6.12, U4.1
/SWA_NC: P6.7, P6.8, P6.9, U4.4
/SWA_NO: P6.1, P6.2, P6.3, U4.6
GND: C4.2, C5.2, C9.2, C10.2, C11.2, C14.2, C15.2, C16.2, C17.2, C18.2, C19.2, C20.2, D2.1, J1.2, J1.3, J2.1, P1.2, P2.21, P2.22, P2.23, P2.24, P3.2, P4.1, P7.1, Q1*.2, Q3*.2, Q4*.2, R16.2, RV1.3, RV2.3, RV6*.3, RV7*.3, RV8.3, SW1.1, U1.11, U2.4, U3.3, U4.3, U5.3, U5.4, U5.23, U6.1
unnamed: C1.1, D1.2, RV5*.1, U2.3
unnamed: C1.2, R1.1
unnamed: C2.1, C7.2, U1.1, U1.2
unnamed: C2.2, RV3.2, RV3.3, RV3.4
unnamed: C3.1, C8.2, U1.13, U1.14
unnamed: C3.2, RV4.2, RV4.3, RV4.4
unnamed: C4.1, R4.1, U1.3
unnamed: C5.1, R5.1, U1.12
unnamed: C6*.2, R3.1, R6.2, U2.2
unnamed: C7.1, R7.2
unnamed: C8.1, R8.2
unnamed: C12.1, R14.1, U2.5
unnamed: C12.2, RV8.2
unnamed: C13.1, R15.2, R17*.2, RV9.1
unnamed: C13.2, U2.6, U2.7
unnamed: D2.2, R10.2
unnamed: D3.4, D3.5, D3.6, R11*.1
unnamed: D4.4, D4.5, D4.6, R13.1
unnamed: D5.4, D5.5, D5.6, R19*.1
unnamed: J1.1, R1.2
unnamed: J2.2, R7.1
unnamed: J2.3, R8.1
unnamed: Q1*.1, R9*.1
unnamed: Q1*.3, R11*.2, R19*.2
unnamed: Q3*.1, R12*.1
unnamed: Q3*.3, R13.2
unnamed: Q4*.1, R17*.1
unnamed: Q4*.3, R18*.2
unnamed: R2*.1, RV5*.2, RV5*.3
unnamed: R4.2, RV3.5, RV3.6
unnamed: R5.2, RV4.5, RV4.6
unnamed: R16.1, RV9.2, RV9.3
unnamed: RV1.2, U1.5
unnamed: RV2.2, U1.10
unnamed: RV3.1, U1.6, U1.7
unnamed: RV4.1, U1.8, U1.9
unnamed: SW1.2, U5.22
