jreus/imac-pcb/(commit log)

2016-12-22 initial project commit
    [imac-pcb.kicad_pcb, imac-pcb.sch]
2016-12-27 added BOM
    [imac-pcb-BOM.ods]
2016-12-27 schematic changes & moved datasheet files
    [imac-pcb.sch]
2016-12-27 updated top-level flowchart and fixed issues with simulations
2016-12-27 updated bom
    [imac-pcb-BOM.ods]
2016-12-27 small schematic updates
    [imac-pcb.sch]
2016-12-30 updated system flowchart
2016-12-30 continued work on schematics
    [imac-pcb.sch]
2017-01-03 simulations for CREE SMD leds and driver circuits
2017-01-03 bom updates
    [imac-pcb-BOM.ods, imac-pcb.sch]
2017-01-03 simulation of p-fet voltage chooser
2017-01-03 added schematic libs for cree and nx semiconductor components
2017-01-03 added led drivers, voltage selector, power conditioning to the schematic
    [imac-pcb.sch]
2017-01-06 modifications to schematic libraries
2017-01-06 new footprint modules for PLCC6 and SOD-323F
2017-01-06 added datasheets for power led and trimpots
2017-01-06 begin work on pcb layout
    [imac-pcb-BOM.ods, imac-pcb.kicad_pcb, imac-pcb.sch]
2017-01-07 created footprint modules for Arduino micro, trimpots, RCA plug, patchbays, terminal blocks
2017-01-07 added printable schematic
2017-01-07 small updates to schematic symbols
2017-01-07 updates to BOM
    [imac-pcb-BOM.ods]
2017-01-07 begin layout of pcb
    [imac-pcb.kicad_pcb, imac-pcb.sch]
2017-01-16 updated print schematic
2017-01-16 new footprints added
2017-01-16 added new schematic symbols
2017-01-16 major work on PCB layout
    [imac-pcb-B.Cu.gbl, imac-pcb-B.Mask.gbs, imac-pcb-B.SilkS.gbo, imac-pcb-F.Cu.gtl, imac-pcb-F.Mask.gts, imac-pcb-F.Paste.gtp, imac-pcb-F.SilkS.gto, imac-pcb-NPTH.drl]
2017-01-19 finished routing & moving references in silkscreen
    [imac-pcb.kicad_pcb]
2017-01-19 first draft of gerbers
    [imac-pcb-B.Cu.gbl, imac-pcb-B.Mask.gbs, imac-pcb-B.SilkS.gbo, imac-pcb-F.Cu.gtl, imac-pcb-F.Mask.gts, imac-pcb-F.Paste.gtp, imac-pcb-F.SilkS.gto, imac-pcb-NPTH.drl]
2017-01-29 added datasheets and printable schematic and pcb
2017-01-29 final gerbers for v01 run
    [imac-pcb-B.Cu.gbl, imac-pcb-B.Mask.gbs, imac-pcb-B.SilkS.gbo, imac-pcb-F.Cu.gtl, imac-pcb-F.Mask.gts, imac-pcb-F.Paste.gtp, imac-pcb-F.SilkS.gto, imac-pcb-NPTH.drl]
2017-01-29 final schematic for run v01
    [imac-pcb-BOM.csv, imac-pcb-BOM.ods, imac-pcb.kicad_pcb]
